alexDickhans/eit/LTSpice/sbomco3b/xtr200-PSpiceFiles/SCHEMATIC1/Transient_Testing/PSpiceDiagnosticReport.xlsx

Sheet: Simulation Settings
Category | Simulation Parameter Name | Value
Transient Analysis | Delta Maximum | 0.0002
 | Delta Minimum | 1e-14
 | METHOD | 0
 | MINSIMPTS | 50
 | DMFACTOR | 1
 | RMIN | 1e-18
Tolerance | ABSTOL | 1e-12
 | TRTOL | 7
 | VNTOL | 1e-06
 | CHGTOL | 1e-14
 | RELTOL | 0.001
Iteration Limits | ITL1 | 150
 | ITL2 | 20
 | ITL4 | 10
 | ITL5 | 0
 | ITL6 | 0
 | GMINSTEPS | 0
 | PTRANSTEP | 0
Convergence | ADVCONV | 1
 | STEPGMIN | 0
 | NOSTEPDEP | 0
 | CONVAID | 0
 | GMINSRC | 0
 | NOGMINI | 0
 | NOOPITER | 0
 | NOSTEPSRC | 0
 | PSEUDOTRAN | 0
 | STEPGMIN | 0
 | BRKDEPSRC | 0
 | TRANCONV | 0
 | TRANCONV1 | 0
 | CSHUNT | 0
Semiconductors | BJTCJ | 0
 | DIODECJO | 0
 | DIODERS | 0
 | JFETCJ | 0
 | MOSCJ | 0
 | DEFAD MOSFET | 0
 | DEFAS MOSFET | 0
 | DEFL MOSFET | 0.0001
 | DEFW MOSFET | 0.0001
Output | ACCT | 0
 | LIBRARY | 0
 | LIST | 0
 | NOBIAS | 0
 | NODE | 0
 | NOECHO | 0
 | NOOUTMSG | 0
 | NOPAGE | 0
 | NOPRBMSG | 0
 | EXPAND | 0
 | NOMOD | 0
 | OPTS | 0
 | WIDTH | 80
 | NUMDGT | 4
 | LIMPTS | 0
Bias Point | NOICTRANSLATE | 0
 | NOREUSE | 0
 | LOADBIAS | 0
 | BPPSEUDOTRAN | 0
Digital | DIGFREQ | 10000000000
 | DIGDRVF | 2
 | DIGDRVZ | 20000
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
