alexDickhans/eit/LTSpice/sbomco3b/XTR200.png

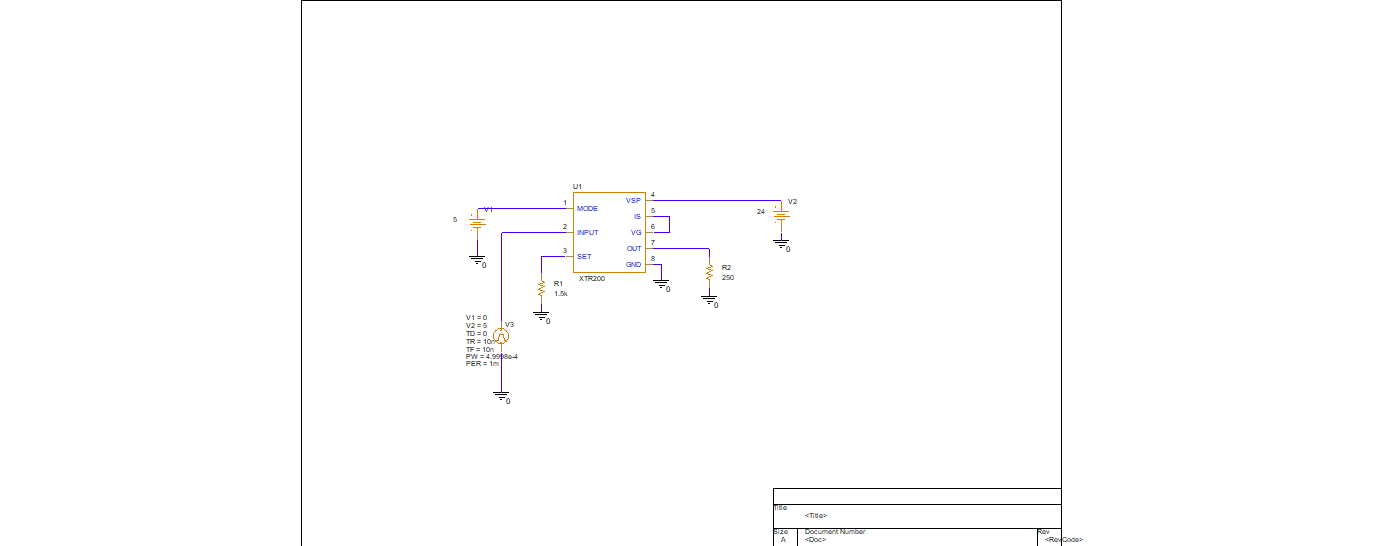
LTSpice/sbomco3b/XTR200.png
