alexDickhans/eit/production/bom.csv

Designator | Comment | Footprint | Qty | LCSC Part #
A1 | RaspberryPi_Pico_W | Module:RaspberryPi_Pico_W_SMD_HandSolder | 1
C1,C3,C8,C10,C13,C17,C18,C21,C27,C28,C30,C32,C33,C34,C36,C43,C45,C46,C48,C51,C52,C54 | 0.1u | Capacitor_SMD:C_0402_1005Metric | 22 | C343047
C2,C4,C11,C15,C20,C22,C23,C24,C25,C26,C29,C31,C35,C37,C40,C41,C42,C44,C47,C49,C50,C55 | 1u | Capacitor_SMD:C_0603_1608Metric | 22 | C342956
C5 | 10u | Capacitor_SMD:C_1210_3225Metric | 1 | C18739
C6,C38,C53 | 0.1u | Capacitor_SMD:C_0402_1005Metric | 3 | C1525
C7 | 10u | Capacitor_SMD:C_0805_2012Metric | 1 | C95841
C9,C14,C16,C19 | 0.1u | Capacitor_SMD:C_0603_1608Metric | 4 | C14663
C12,C39 | 1n | Capacitor_SMD:C_0402_1005Metric | 2 | C1523
D1 | MBR0540T1G | Diode_SMD:D_SOD-123 | 1 | C21353
J1 | Conn_01x05_Pin | Connector_PinHeader_2.54mm:PinHeader_1x05_P2.54mm_Vertical | 1 | C188243
J2 | Conn_02x08_Top_Bottom | Connector_PinHeader_2.54mm:PinHeader_2x08_P2.54mm_Vertical | 1 | C68234
R1,R2,R4,R8,R9,R11,R12,R13 | 10k | Resistor_SMD:R_0402_1005Metric | 8 | C25744
R3,R5,R6,R7 | 10 | Resistor_SMD:R_0402_1005Metric | 4 | C25077
R10 | 820 | Resistor_SMD:R_0603_1608Metric | 1 | C19700783
RN1 | 100k | Resistor_SMD:R_Array_Convex_4x0612 | 1 | C1731595
RN2 | 5k | Resistor_SMD:R_Array_Convex_2x0606 | 1 | C1731135
U1 | ADS8354IRTER | ADS8354:RTE0016D | 1 | C2670004
U2 | DAC80502 | Package_SON:Texas_DRX_WSON-10_2.5x2.5mm_P0.5mm | 1 | C1880990
U3,U4 | PGA281AxPW | Package_SO:TSSOP-16_4.4x5mm_P0.65mm | 2 | C69359
U5 | OPA192IDBVR | OPA192:DBV0005A_N | 1 | C139648
U6,U8,U10,U11 | ADG5206BRUZ-RL7 | ADG5206:RU_28_ADI | 4 | C657435
U7,U9 | 74HC595 | Package_SO:SOIC-16_3.9x9.9mm_P1.27mm | 2 | C10092
