alexDickhans/eit/components/ul_TPS62901RPJR/RPJ0009A.stp

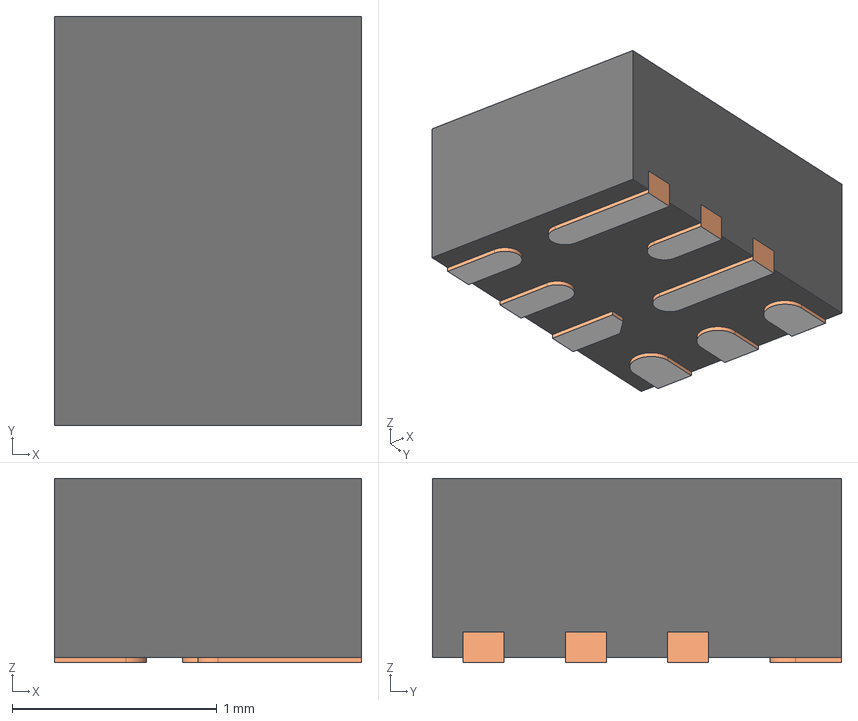
[picture p14: CAD file, 2026-05-09]
components/ul_TPS62901RPJR/RPJ0009A.stp
1.50 x 2.00 x 0.9 mm
FRAME-RPJ0009A
BODY-QFN
PIN1-ID
