alexDickhans/eit/LTSpice/Draft1.asc

C1: Cap; 10µ; Rser=0.005
C2: Cap; 10µ; Rser=0.05
C3: Cap; 4.7µ
C4: Cap; 10µ
L1: ind; 2.2µ
R1: Res; 200k
R2: Res; 490k
R3: Res; 10k
R4: Res; 1k
R5: Res; 150k
R6: Res; 100k
U1: LT3045
V1: Voltage; 18; Rser=0
Named nets: 0, VOUT
.noise V(VOUT) V1 dec 100 100 3Meg
