alexDickhans/eit/LTSpice/Draft2.asc

C1: Cap; 10µ; Rser=0.5
C2: Cap; 10µ; Rser=0.05
L1: ind; 22µ; Ipk=1.6 Rser=96m Rpar=5.17K Cpar=0 mfg="Bourns, Inc." pn="SRR6038-220Y"
R1: Res; 10k
V1: Voltage; 18; AC 1; Rser=0
Named nets: 0, VOUT
.ac dec 100 550k 650k
