alexDickhans/eit/LTSpice/Draft3.asc

C1: Cap; 4.7µ
C2: Cap; 4.7µ
C3: Cap; 1n
R1: Res; 1
R2: Res; 10
U2: ADM7170-3.3
V1: Voltage; 5; Rser=0
Named nets: 0
.tran 50ms
