alexDickhans/eit/LTSpice/Draft4.asc

C1: Cap; 150p
C2: Cap; 0.1µ
R1: Res; 15k
R2: Res; 0.01
R3: Res; 50k
U1: XTR200
V1: Voltage; PULSE(0 1 100u 5n 5n 100u 200u 100)
V2: Voltage; 15; Rser=0
V3: Voltage; 5; Rser=0
Named nets: 0
.tran 0 0.5ms 0 1ns
