alexDickhans/eit/LTSpice/howland current pump.asc

C1: Cap; 2p
C2: Cap; 150p
R1: Res; 100k
R2: Res; 105k
R3: Res; 100k
R4: Res; 5k
R5: Res; 100k
R6: Res; 15k
R7: Res; 0.01
R8: Res; 1k
U2: OPAx192
V1: Voltage; PULSE(0 2.5 0.04ms 5ns 5ns 0.04ms 0.08ms 100); AC 1; Rser=0
V2: Voltage; 15; Rser=0
Named nets: 0, op-amp+, op-amp-output
.tran 0.1ms
