alexDickhans/eit/(list of files, drawings)

Other design files:
LTSpice/OPA192/OPAx192.OLB
LTSpice/OPA192/OPAx192_Test_Circuit.OPJ
LTSpice/sbomco3b/XTR200.OLB
LTSpice/sbomco3b/xtr200.opj
