alexDickhans/eit/eit.kicad_pcb

## KiCad design eit.kicad_pcb (2026-11-06)

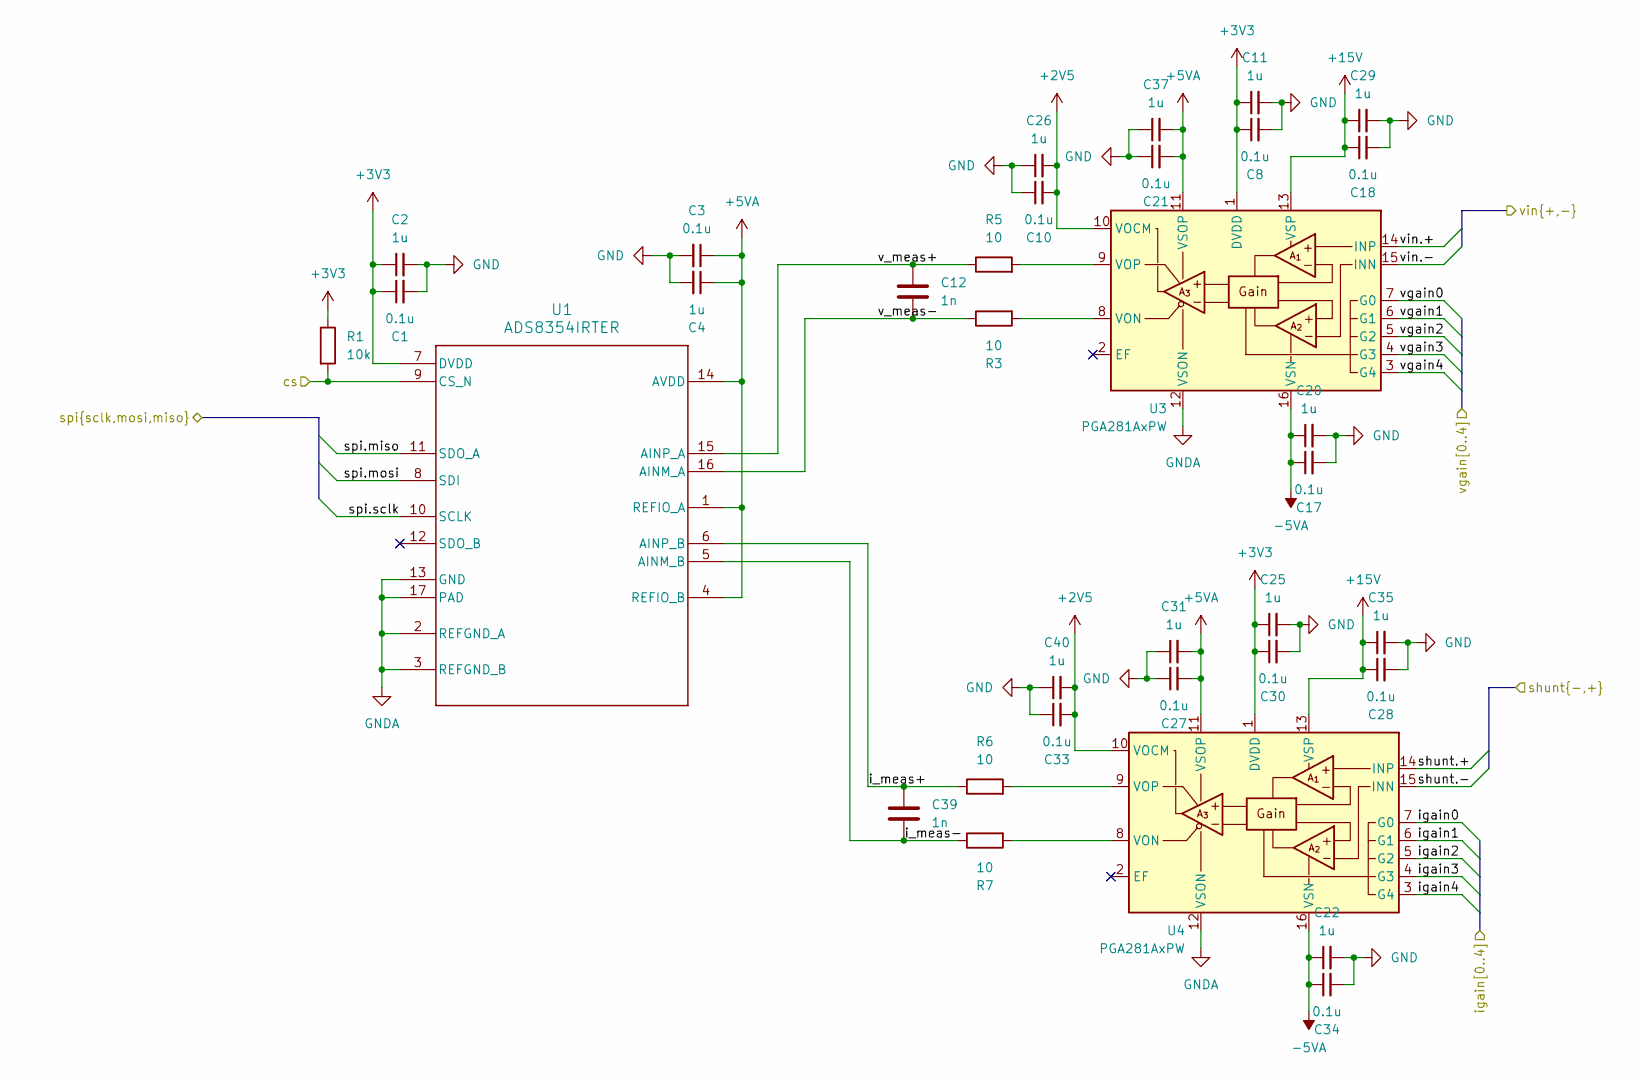
[picture p15: schematic voltage_measurement.kicad_sch]

Parts:
C1, C3, C8, C10, C17, C18, C21, C27, C28, C30, C33, C34: 0.1u; C_0402_1005Metric; LCSC Part # C343047
C2, C4, C11, C20, C22, C25, C26, C29, C31, C35, C37, C40: 1u; C_0603_1608Metric; LCSC Part # C342956
C12, C39: 1n; C_0402_1005Metric; LCSC Part # C1523
R1: 10k; R_0402_1005Metric; LCSC Part # C25744
R3, R5, R6, R7: 10; R_0402_1005Metric; LCSC Part # C25077
U1: ADS8354IRTER; RTE0016D; LCSC Part # C2670004
U3, U4: PGA281AxPW; TSSOP-16_4.4x5mm_P0.65mm; LCSC Part # C69359

Connections:
+2V5: C10.2, C26.2, C33.2, C40.2, U3.10 (VOCM), U4.10 (VOCM); also elsewhere on the board
+3V3: C1.1, C2.1, C8.1, C11.1, C25.1, C30.1, R1.1, U1.7 (DVDD), U3.1 (DVDD), U4.1 (DVDD); also elsewhere on the board
+5VA: C3.1, C4.1, C21.2, C27.2, C31.2, C37.2, U1.1 (REFIO_A), U1.4 (REFIO_B), U1.14 (AVDD), U3.11 (VSOP), U4.11 (VSOP); also elsewhere on the board
+15V: C18.1, C28.1, C29.1, C35.1, U3.13 (VSP), U4.13 (VSP); also elsewhere on the board
-5VA: C17.1, C20.1, C22.1, C34.1, U3.16 (VSN), U4.16 (VSN); also elsewhere on the board
/Current Injection/shunt.+: U4.14 (INP); also elsewhere on the board
/Current Injection/shunt.-: U4.15 (INN); also elsewhere on the board
/Current Injection/spi.miso: U1.11 (SDO_A); also elsewhere on the board
/Current Injection/spi.mosi: U1.8 (SDI); also elsewhere on the board
/Current Injection/spi.sclk: U1.10 (SCLK); also elsewhere on the board
/Microcontroller/adc_cs: R1.2, U1.9 (CS_N); also elsewhere on the board
/Microcontroller/igain0: U4.7 (G0); also elsewhere on the board
/Microcontroller/igain1: U4.6 (G1); also elsewhere on the board
/Microcontroller/igain2: U4.5 (G2); also elsewhere on the board
/Microcontroller/igain3: U4.4 (G3); also elsewhere on the board
/Microcontroller/igain4: U4.3 (G4); also elsewhere on the board
/Microcontroller/vgain0: U3.7 (G0); also elsewhere on the board
/Microcontroller/vgain1: U3.6 (G1); also elsewhere on the board
/Microcontroller/vgain2: U3.5 (G2); also elsewhere on the board
/Microcontroller/vgain3: U3.4 (G3); also elsewhere on the board
/Microcontroller/vgain4: U3.3 (G4); also elsewhere on the board
/Mux/vin.+: U3.14 (INP); also elsewhere on the board
/Mux/vin.-: U3.15 (INN); also elsewhere on the board
/Voltage Measurement/i_meas+: C39.1, R6.1, U1.6 (AINP_B)
/Voltage Measurement/i_meas-: C39.2, R7.1, U1.5 (AINM_B)
/Voltage Measurement/v_meas+: C12.1, R5.1, U1.15 (AINP_A)
/Voltage Measurement/v_meas-: C12.2, R3.1, U1.16 (AINM_A)
GND: C1.2, C2.2, C3.2, C4.2, C8.2, C10.1, C11.2, C17.2, C18.2, C20.2, C21.1, C22.2, C25.2, C26.1, C27.1, C28.2, C29.2, C30.2, C31.1, C33.1, C34.2, C35.2, C37.1, C40.1, U1.2 (REFGND_A), U1.3 (REFGND_B), U1.13 (GND), U1.17 (PAD), U3.12 (VSON), U4.12 (VSON); also elsewhere on the board
unnamed: R3.2, U3.8 (VON)
unnamed: R5.2, U3.9 (VOP)
unnamed: R7.2, U4.8 (VON)
unnamed: R6.2, U4.9 (VOP)

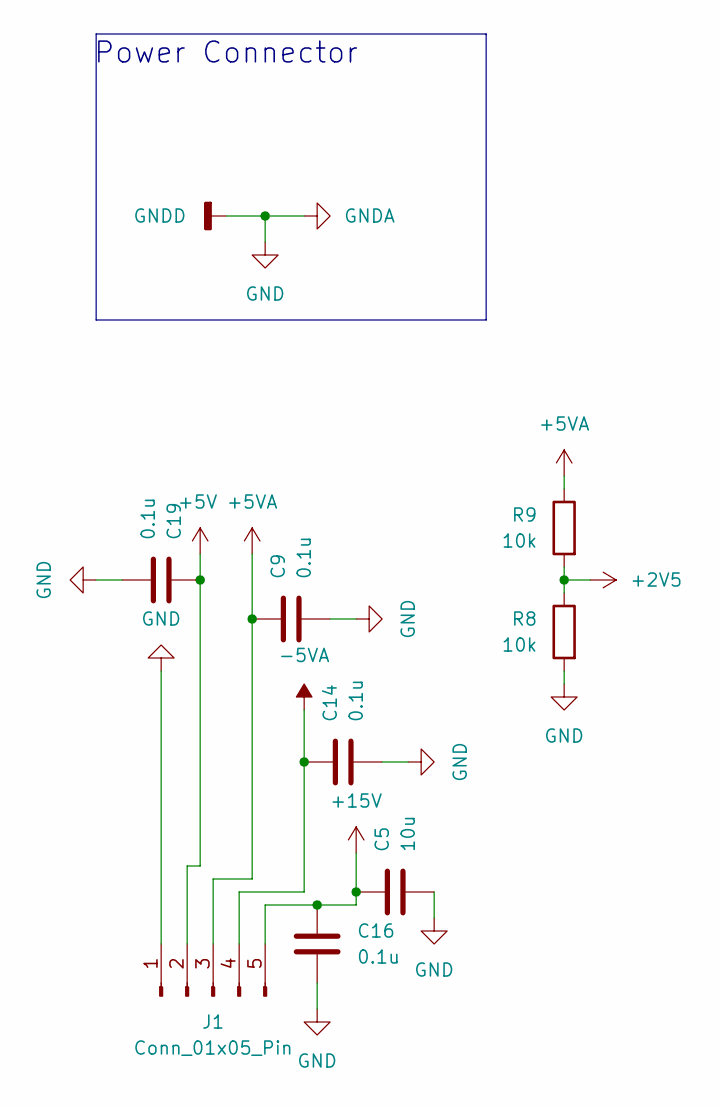
[picture p16: schematic power.kicad_sch, Power Electronics]

Parts:
C5: 10u; C_1210_3225Metric; LCSC Part # C18739
C9, C14, C16, C19: 0.1u; C_0603_1608Metric; LCSC Part # C14663
J1: Conn_01x05_Pin; PinHeader_1x05_P2.54mm_Vertical; LCSC Part # C188243
R8, R9: 10k; R_0402_1005Metric; LCSC Part # C25744

Connections:
+2V5: R8.1, R9.2; also elsewhere on the board
+5V: C19.2, J1.2; also elsewhere on the board
+5VA: C9.2, J1.3, R9.1; also elsewhere on the board
+15V: C5.1, C16.2, J1.5; also elsewhere on the board
-5VA: C14.2, J1.4; also elsewhere on the board
GND: C5.2, C9.1, C14.1, C16.1, C19.1, J1.1, R8.2; also elsewhere on the board

Notes on the sheet:
Power Connector

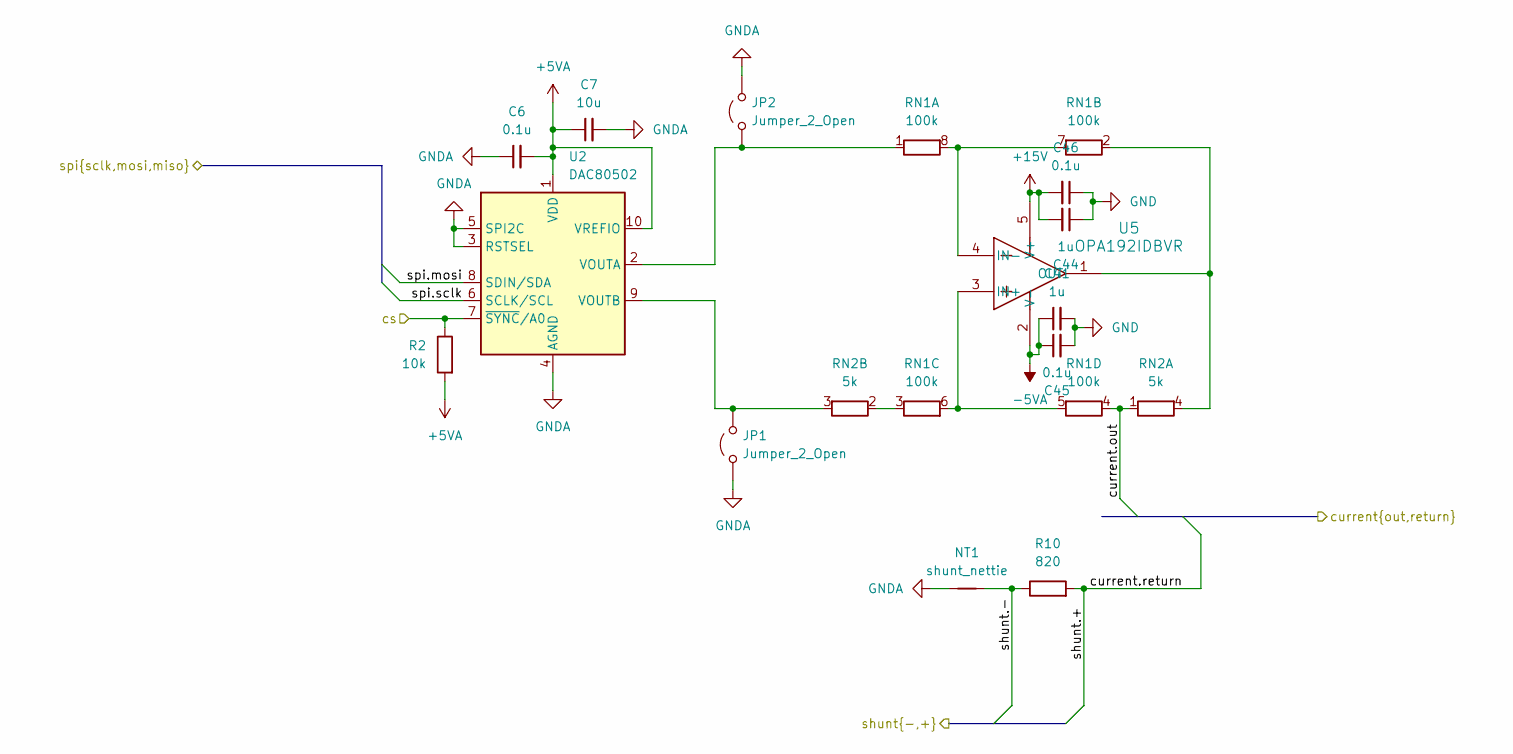
[picture p17: schematic current_injection.kicad_sch]

Parts:
C6: 0.1u; C_0402_1005Metric; LCSC Part # C1525
C7: 10u; C_0805_2012Metric; LCSC Part # C95841
C41, C44: 1u; C_0603_1608Metric; LCSC Part # C342956
C45, C46: 0.1u; C_0402_1005Metric; LCSC Part # C343047
JP1, JP2: Jumper_2_Open; SolderJumper-2_P1.3mm_Open_RoundedPad1.0x1.5mm
NT1: shunt_nettie; NetTie-2_SMD_Pad0.5mm
R2: 10k; R_0402_1005Metric; LCSC Part # C25744
R10: 820; R_0603_1608Metric; LCSC Part # C19700783
RN1: 100k; R_Array_Convex_4x0612; LCSC Part # C1731595
RN2: 5k; R_Array_Convex_2x0606; LCSC Part # C1731135
U2: DAC80502; Texas_DRX_WSON-10_2.5x2.5mm_P0.5mm; LCSC Part # C1880990
U5: OPA192IDBVR; DBV0005A_N; LCSC Part # C139648

Connections:
+5VA: C6.2, C7.1, R2.2, U2.1 (VDD), U2.10 (VREFIO); also elsewhere on the board
+15V: C44.2, C46.2, U5.5 (V+); also elsewhere on the board
-5VA: C41.1, C45.1, U5.2 (V-); also elsewhere on the board
/Current Injection/cs: R2.1, U2.7 (~SYNC/A0); also elsewhere on the board
/Current Injection/current.out: RN1.4 (R4.1), RN2.1 (R1.1); also elsewhere on the board
/Current Injection/shunt.+: R10.2; also elsewhere on the board
/Current Injection/shunt.-: NT1.2, R10.1; also elsewhere on the board
/Current Injection/spi.mosi: U2.8 (SDIN/SDA); also elsewhere on the board
/Current Injection/spi.sclk: U2.6 (SCLK/SCL); also elsewhere on the board
GND: C6.1, C7.2, C41.2, C44.1, C45.2, C46.1, JP1.1 (A), JP2.2 (B), NT1.1, U2.3 (RSTSEL), U2.4 (AGND), U2.5 (SPI2C); also elsewhere on the board
unnamed: JP1.2 (B), RN2.3 (R2.2), U2.9 (VOUTB)
unnamed: JP2.1 (A), RN1.1 (R1.1), U2.2 (VOUTA)
unnamed: RN1.7 (R2.2), RN1.8 (R1.2), U5.4 (IN-)
unnamed: RN1.2 (R2.1), RN2.4 (R1.2), U5.1 (OUT)
unnamed: RN1.3 (R3.1), RN2.2 (R2.1)
unnamed: RN1.5 (R4.2), RN1.6 (R3.2), U5.3 (IN+)

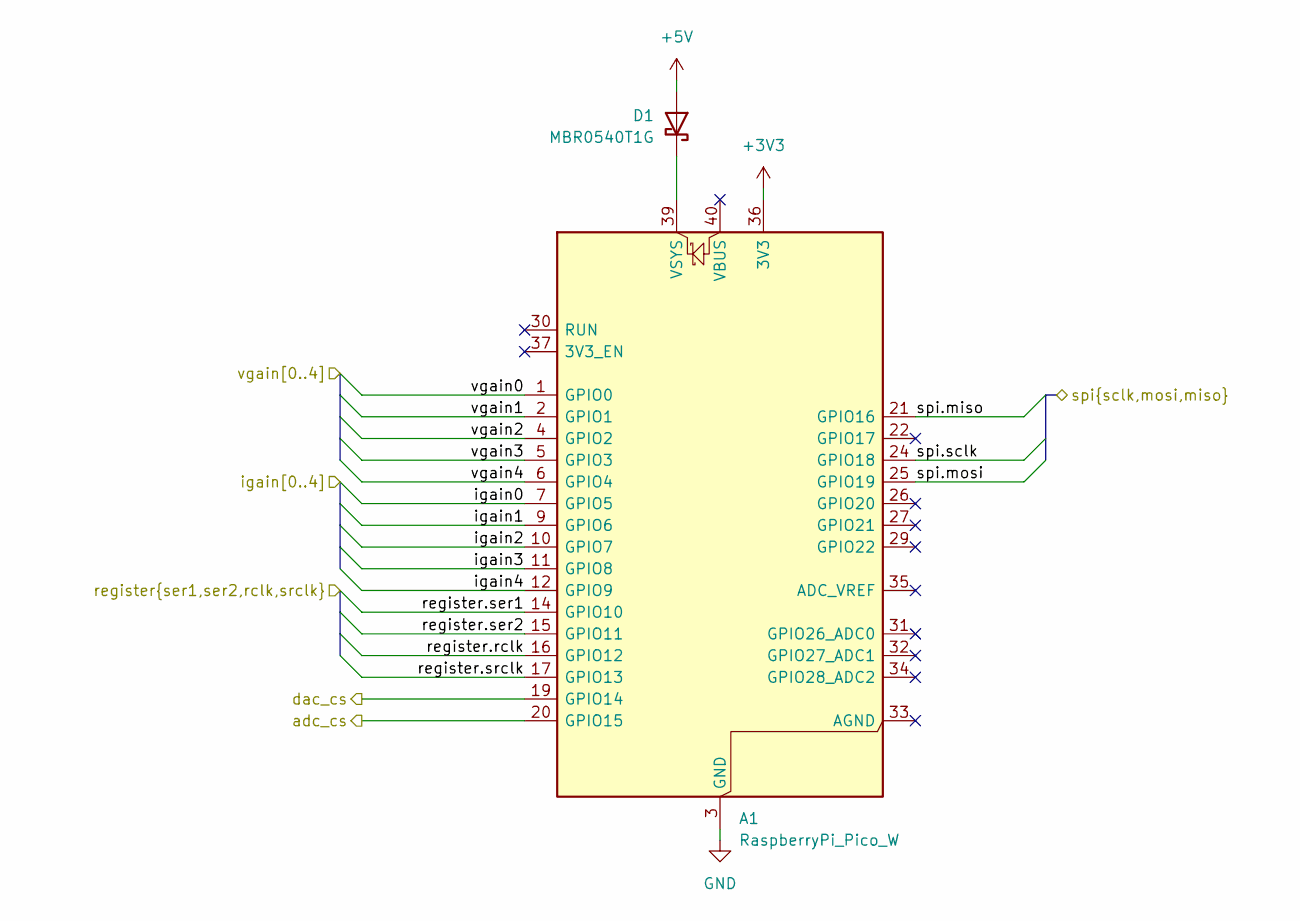
[picture p18: schematic microcontroller.kicad_sch]

Parts:
A1: RaspberryPi_Pico_W; RaspberryPi_Pico_W_SMD_HandSolder
D1: MBR0540T1G; D_SOD-123; LCSC Part # C21353

Connections:
+3V3: A1.36 (3V3); also elsewhere on the board
+5V: D1.2 (A); also elsewhere on the board
/Current Injection/cs: A1.19 (GPIO14); also elsewhere on the board
/Current Injection/spi.miso: A1.21 (GPIO16); also elsewhere on the board
/Current Injection/spi.mosi: A1.25 (GPIO19); also elsewhere on the board
/Current Injection/spi.sclk: A1.24 (GPIO18); also elsewhere on the board
/Microcontroller/adc_cs: A1.20 (GPIO15); also elsewhere on the board
/Microcontroller/igain0: A1.7 (GPIO5); also elsewhere on the board
/Microcontroller/igain1: A1.9 (GPIO6); also elsewhere on the board
/Microcontroller/igain2: A1.10 (GPIO7); also elsewhere on the board
/Microcontroller/igain3: A1.11 (GPIO8); also elsewhere on the board
/Microcontroller/igain4: A1.12 (GPIO9); also elsewhere on the board
/Microcontroller/register.rclk: A1.16 (GPIO12); also elsewhere on the board
/Microcontroller/register.ser1: A1.14 (GPIO10); also elsewhere on the board
/Microcontroller/register.ser2: A1.15 (GPIO11); also elsewhere on the board
/Microcontroller/register.srclk: A1.17 (GPIO13); also elsewhere on the board
/Microcontroller/vgain0: A1.1 (GPIO0); also elsewhere on the board
/Microcontroller/vgain1: A1.2 (GPIO1); also elsewhere on the board
/Microcontroller/vgain2: A1.4 (GPIO2); also elsewhere on the board
/Microcontroller/vgain3: A1.5 (GPIO3); also elsewhere on the board
/Microcontroller/vgain4: A1.6 (GPIO4); also elsewhere on the board
GND: A1.3 (GND), A1.8 (GND), A1.13 (GND), A1.18 (GND), A1.23 (GND), A1.28 (GND), A1.38 (GND); also elsewhere on the board
unnamed: A1.39 (VSYS), D1.1 (K)

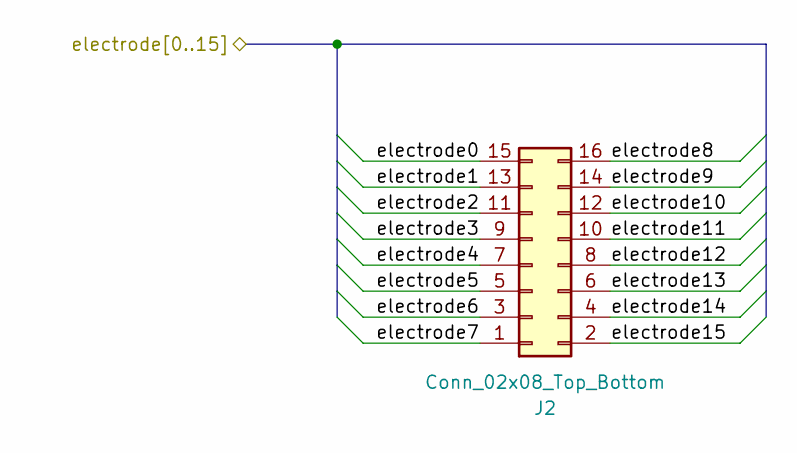
[picture p19: schematic Sensor Interface.kicad_sch]

Parts:
J2: Conn_02x08_Top_Bottom; PinHeader_2x08_P2.54mm_Vertical; LCSC Part # C68234

Connections:
/Mux/electrode0: J2.15; also elsewhere on the board
/Mux/electrode1: J2.13; also elsewhere on the board
/Mux/electrode2: J2.11; also elsewhere on the board
/Mux/electrode3: J2.9; also elsewhere on the board
/Mux/electrode4: J2.7; also elsewhere on the board
/Mux/electrode5: J2.5; also elsewhere on the board
/Mux/electrode6: J2.3; also elsewhere on the board
/Mux/electrode7: J2.1; also elsewhere on the board
/Mux/electrode8: J2.16; also elsewhere on the board
/Mux/electrode9: J2.14; also elsewhere on the board
/Mux/electrode10: J2.12; also elsewhere on the board
/Mux/electrode11: J2.10; also elsewhere on the board
/Mux/electrode12: J2.8; also elsewhere on the board
/Mux/electrode13: J2.6; also elsewhere on the board
/Mux/electrode14: J2.4; also elsewhere on the board
/Mux/electrode15: J2.2; also elsewhere on the board

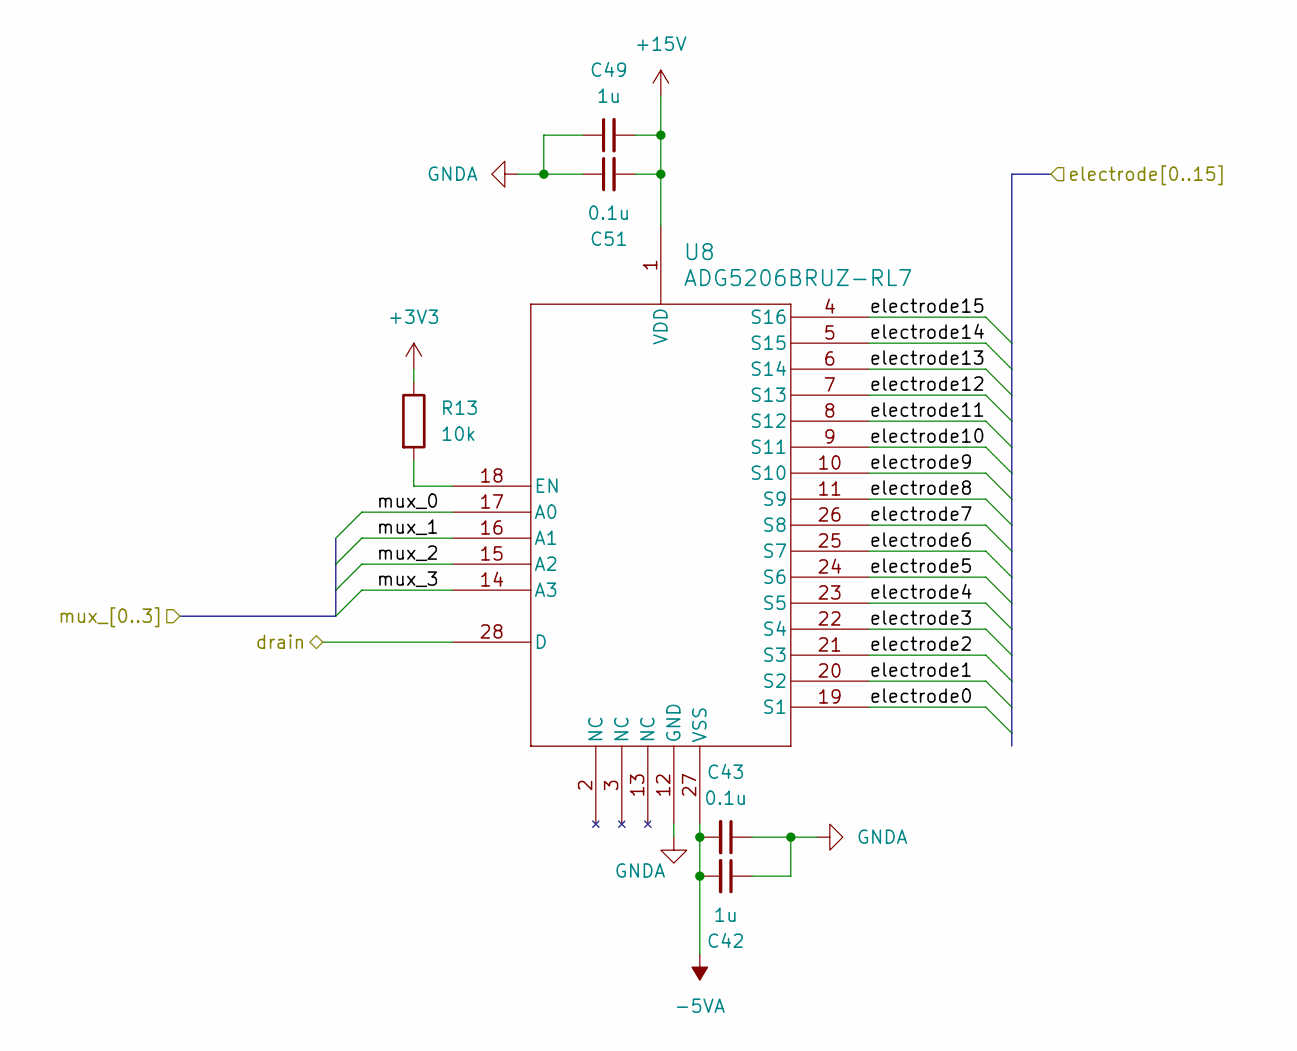
[picture p20: schematic single_mux.kicad_sch]

Parts:
C42, C49: 1u; C_0603_1608Metric; LCSC Part # C342956
C43, C51: 0.1u; C_0402_1005Metric; LCSC Part # C343047
R13: 10k; R_0402_1005Metric; LCSC Part # C25744
U8: ADG5206BRUZ-RL7; RU_28_ADI; LCSC Part # C657435

Connections:
+3V3: R13.1; also elsewhere on the board
+15V: C49.2, C51.2, U8.1 (VDD); also elsewhere on the board
-5VA: C42.2, C43.2, U8.27 (VSS); also elsewhere on the board
/Mux/Shift Register1/mux2_0: U8.17 (A0); also elsewhere on the board
/Mux/Shift Register1/mux2_1: U8.16 (A1); also elsewhere on the board
/Mux/Shift Register1/mux2_2: U8.15 (A2); also elsewhere on the board
/Mux/Shift Register1/mux2_3: U8.14 (A3); also elsewhere on the board
/Mux/electrode0: U8.19 (S1); also elsewhere on the board
/Mux/electrode1: U8.20 (S2); also elsewhere on the board
/Mux/electrode2: U8.21 (S3); also elsewhere on the board
/Mux/electrode3: U8.22 (S4); also elsewhere on the board
/Mux/electrode4: U8.23 (S5); also elsewhere on the board
/Mux/electrode5: U8.24 (S6); also elsewhere on the board
/Mux/electrode6: U8.25 (S7); also elsewhere on the board
/Mux/electrode7: U8.26 (S8); also elsewhere on the board
/Mux/electrode8: U8.11 (S9); also elsewhere on the board
/Mux/electrode9: U8.10 (S10); also elsewhere on the board
/Mux/electrode10: U8.9 (S11); also elsewhere on the board
/Mux/electrode11: U8.8 (S12); also elsewhere on the board
/Mux/electrode12: U8.7 (S13); also elsewhere on the board
/Mux/electrode13: U8.6 (S14); also elsewhere on the board
/Mux/electrode14: U8.5 (S15); also elsewhere on the board
/Mux/electrode15: U8.4 (S16); also elsewhere on the board
/Mux/vin.-: U8.28 (D); also elsewhere on the board
GND: C42.1, C43.1, C49.1, C51.1, U8.12 (GND); also elsewhere on the board
unnamed: R13.2, U8.18 (EN)

Parts of its further copies:
C13, C32, C36, C48, C52, C54: 0.1u; C_0402_1005Metric; LCSC Part # C343047
C15, C23, C24, C47, C50, C55: 1u; C_0603_1608Metric; LCSC Part # C342956
R4, R11, R12: 10k; R_0402_1005Metric; LCSC Part # C25744
U6, U10, U11: ADG5206BRUZ-RL7; RU_28_ADI; LCSC Part # C657435

Connections of its further copies:
+3V3: R4.1, R11.1, R12.1; also elsewhere on the board
+15V: C47.2, C48.2, C50.2, C52.2, C54.2, C55.2, U6.1 (VDD), U10.1 (VDD), U11.1 (VDD); also elsewhere on the board
-5VA: C13.2, C15.2, C23.2, C24.2, C32.2, C36.2, U6.27 (VSS), U10.27 (VSS), U11.27 (VSS); also elsewhere on the board
/Current Injection/current.out: U11.28 (D); also elsewhere on the board
/Current Injection/shunt.+: U10.28 (D); also elsewhere on the board
/Mux/Shift Register1/mux1_0: U6.17 (A0); also elsewhere on the board
/Mux/Shift Register1/mux1_1: U6.16 (A1); also elsewhere on the board
/Mux/Shift Register1/mux1_2: U6.15 (A2); also elsewhere on the board
/Mux/Shift Register1/mux1_3: U6.14 (A3); also elsewhere on the board
/Mux/Shift Register/mux1_0: U10.17 (A0); also elsewhere on the board
/Mux/Shift Register/mux1_1: U10.16 (A1); also elsewhere on the board
/Mux/Shift Register/mux1_2: U10.15 (A2); also elsewhere on the board
/Mux/Shift Register/mux1_3: U10.14 (A3); also elsewhere on the board
/Mux/Shift Register/mux2_0: U11.17 (A0); also elsewhere on the board
/Mux/Shift Register/mux2_1: U11.16 (A1); also elsewhere on the board
/Mux/Shift Register/mux2_2: U11.15 (A2); also elsewhere on the board
/Mux/Shift Register/mux2_3: U11.14 (A3); also elsewhere on the board
/Mux/electrode0: U6.19 (S1), U10.19 (S1), U11.19 (S1); also elsewhere on the board
/Mux/electrode1: U6.20 (S2), U10.20 (S2), U11.20 (S2); also elsewhere on the board
/Mux/electrode2: U6.21 (S3), U10.21 (S3), U11.21 (S3); also elsewhere on the board
/Mux/electrode3: U6.22 (S4), U10.22 (S4), U11.22 (S4); also elsewhere on the board
/Mux/electrode4: U6.23 (S5), U10.23 (S5), U11.23 (S5); also elsewhere on the board
/Mux/electrode5: U6.24 (S6), U10.24 (S6), U11.24 (S6); also elsewhere on the board
/Mux/electrode6: U6.25 (S7), U10.25 (S7), U11.25 (S7); also elsewhere on the board
/Mux/electrode7: U6.26 (S8), U10.26 (S8), U11.26 (S8); also elsewhere on the board
/Mux/electrode8: U6.11 (S9), U10.11 (S9), U11.11 (S9); also elsewhere on the board
/Mux/electrode9: U6.10 (S10), U10.10 (S10), U11.10 (S10); also elsewhere on the board
/Mux/electrode10: U6.9 (S11), U10.9 (S11), U11.9 (S11); also elsewhere on the board
/Mux/electrode11: U6.8 (S12), U10.8 (S12), U11.8 (S12); also elsewhere on the board
/Mux/electrode12: U6.7 (S13), U10.7 (S13), U11.7 (S13); also elsewhere on the board
/Mux/electrode13: U6.6 (S14), U10.6 (S14), U11.6 (S14); also elsewhere on the board
/Mux/electrode14: U6.5 (S15), U10.5 (S15), U11.5 (S15); also elsewhere on the board
/Mux/electrode15: U6.4 (S16), U10.4 (S16), U11.4 (S16); also elsewhere on the board
/Mux/vin.+: U6.28 (D); also elsewhere on the board
GND: C13.1, C15.1, C23.1, C24.1, C32.1, C36.1, C47.1, C48.1, C50.1, C52.1, C54.1, C55.1, U6.12 (GND), U10.12 (GND), U11.12 (GND); also elsewhere on the board
unnamed: R4.2, U6.18 (EN)
unnamed: R11.2, U10.18 (EN)
unnamed: R12.2, U11.18 (EN)

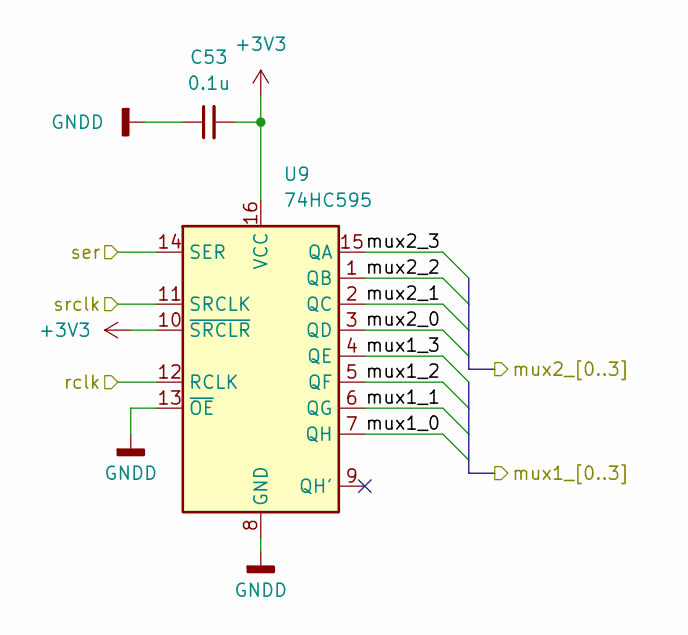
[picture p21: schematic shift_register.kicad_sch]

Parts:
C53: 0.1u; C_0402_1005Metric; LCSC Part # C1525
U9: 74HC595; SOIC-16_3.9x9.9mm_P1.27mm; LCSC Part # C10092

Connections:
+3V3: C53.2, U9.10 (~SRCLR), U9.16 (VCC); also elsewhere on the board
/Microcontroller/register.rclk: U9.12 (RCLK); also elsewhere on the board
/Microcontroller/register.ser1: U9.14 (SER); also elsewhere on the board
/Microcontroller/register.srclk: U9.11 (SRCLK); also elsewhere on the board
/Mux/Shift Register/mux1_0: U9.7 (QH); also elsewhere on the board
/Mux/Shift Register/mux1_1: U9.6 (QG); also elsewhere on the board
/Mux/Shift Register/mux1_2: U9.5 (QF); also elsewhere on the board
/Mux/Shift Register/mux1_3: U9.4 (QE); also elsewhere on the board
/Mux/Shift Register/mux2_0: U9.3 (QD); also elsewhere on the board
/Mux/Shift Register/mux2_1: U9.2 (QC); also elsewhere on the board
/Mux/Shift Register/mux2_2: U9.1 (QB); also elsewhere on the board
/Mux/Shift Register/mux2_3: U9.15 (QA); also elsewhere on the board
GND: C53.1, U9.8 (GND), U9.13 (~OE); also elsewhere on the board

Parts of its further copies:
C38: 0.1u; C_0402_1005Metric; LCSC Part # C1525
U7: 74HC595; SOIC-16_3.9x9.9mm_P1.27mm; LCSC Part # C10092

Connections of its further copies:
+3V3: C38.2, U7.10 (~SRCLR), U7.16 (VCC); also elsewhere on the board
/Microcontroller/register.rclk: U7.12 (RCLK); also elsewhere on the board
/Microcontroller/register.ser2: U7.14 (SER); also elsewhere on the board
/Microcontroller/register.srclk: U7.11 (SRCLK); also elsewhere on the board
/Mux/Shift Register1/mux1_0: U7.7 (QH); also elsewhere on the board
/Mux/Shift Register1/mux1_1: U7.6 (QG); also elsewhere on the board
/Mux/Shift Register1/mux1_2: U7.5 (QF); also elsewhere on the board
/Mux/Shift Register1/mux1_3: U7.4 (QE); also elsewhere on the board
/Mux/Shift Register1/mux2_0: U7.3 (QD); also elsewhere on the board
/Mux/Shift Register1/mux2_1: U7.2 (QC); also elsewhere on the board
/Mux/Shift Register1/mux2_2: U7.1 (QB); also elsewhere on the board
/Mux/Shift Register1/mux2_3: U7.15 (QA); also elsewhere on the board
GND: C38.1, U7.8 (GND), U7.13 (~OE); also elsewhere on the board

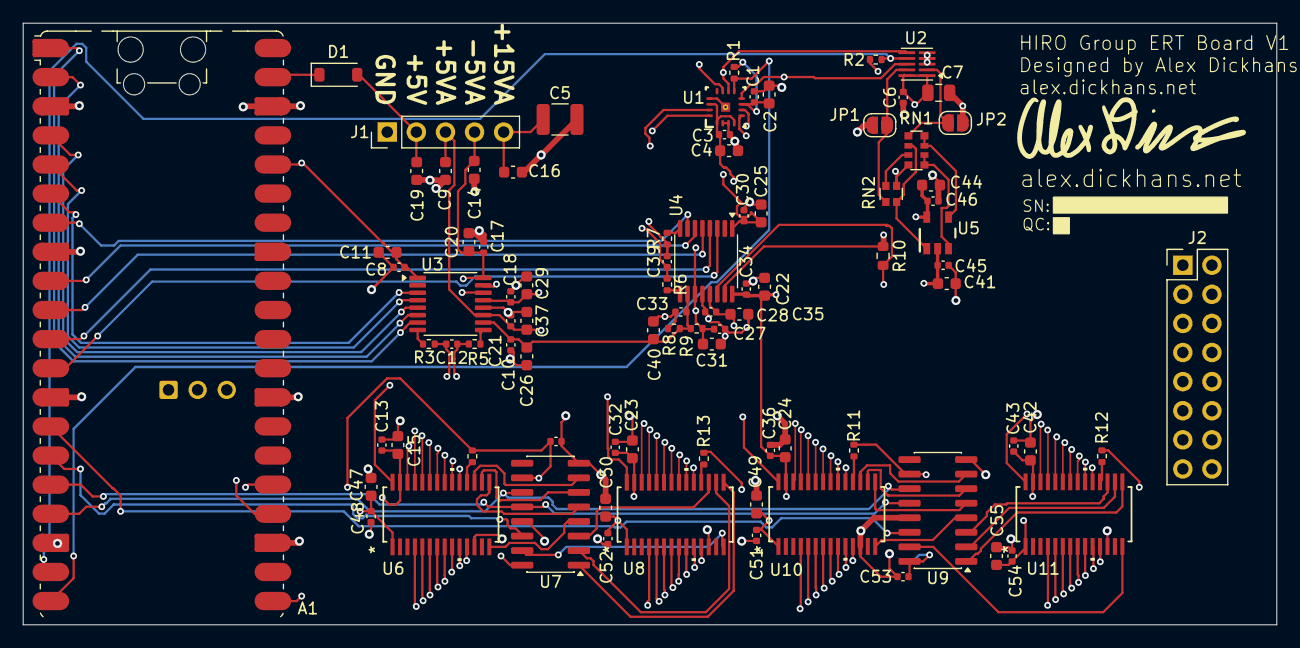
[picture p22: board eit.kicad_pcb from above]

Board: 6 copper layers, 109.4 x 52.5 mm, 88 parts (0 on the bottom side), 82 nets.
