alexDickhans/eit/(commit log)

2026-05-09 Ready to start Layout
    [OPAx192.OLB, OPAx192_Test_Circuit.DSN, OPAx192_Test_Circuit.OPJ, PSpiceDiagnosticReport.xlsx, RPJ0009A.stp, Sensor Interface.kicad_sch, XTR200.DSN, XTR200.OLB]
2026-08-24 Remove gitignore file
    [OPAx192_Test_Circuit.DSN, Sensor Interface.kicad_sch, XTR200.DSN, current_injection.kicad_sch, eit.kicad_pcb, eit.kicad_sch, microcontroller.kicad_sch, mux.kicad_sch]
2026-08-26 Ready for manufacturing
    [Sensor Interface.kicad_sch, current_injection.kicad_sch, eit.kicad_pcb, microcontroller.kicad_sch, power.kicad_sch, shift_register.kicad_sch, single_mux.kicad_sch, voltage_measurement.kicad_sch]
2026-08-26 ready for reveiw
    [eit.kicad_pcb]
2026-08-26 Ready for review w/ jlc parts
    [current_injection.kicad_sch, eit.kicad_pcb, power.kicad_sch, voltage_measurement.kicad_sch]
2026-11-06 Document the ERT board and refresh fabrication files
    The diode value now matches LCSC C21353 (MBR0540T1G). Gerbers, the combined drill file, the BOM, and the placement file are exported from this board. The old zip's drill maps and the truncated IPC netlist are gone.
    [bom.csv, eit.kicad_pcb, microcontroller.kicad_sch, position.csv]
